joneschmidt/GradeCrossing/README.md

# GradeCrossing
Arduino code for a model railroad grade crossing controller

05/06/2024 updated with version 3.2 of the sketch
11/17/2022 updated with version 3.1 of the sketch
