joneschmidt/GradeCrossing/GradeCrossingBoardV1.1.pdf

### Grade Crossing Board V1.1

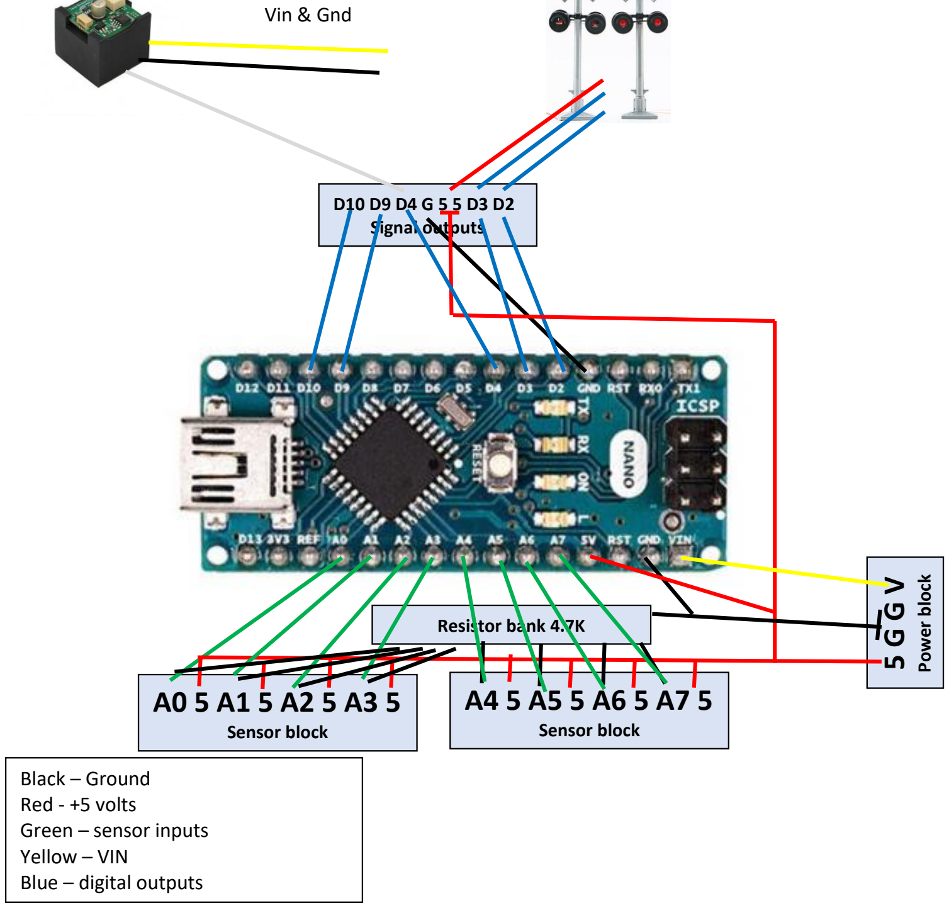
[picture p2: figure]
Sensor block; Vin & Gnd; D10 D9 D4 G 5 5 D3 D2 Signal outputs; Power block; Black – Ground Red - +5 volts Green – sensor inputs Yellow – VIN Blue – digital outputs; Resistor bank 4.7K

3/28/2022 10:35 AM

Iowa Scaled Engr
Soundbytes Crossing Bell

Walthers SceneMaster Crossing Flashers 510 Ω on common black lead to +5

### Grade Crossing Board V1.1

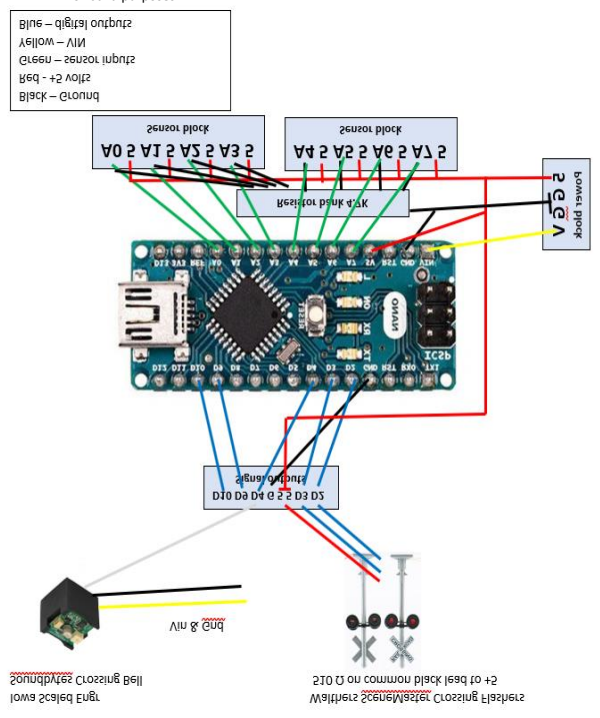
[picture p3: figure]

3/28/2022 10:35 AM

Underside – for build purposes
