joneschmidt/GradeCrossing/(commit log)

2022-07-10 Add files via upload
    Updated to GradeCrossing 3.0 This code is a major restructuring, with reworking the code for gate control servos.
2024-05-20 Clean, generic grade crossing sketch
    For 1 track crossing, but examples for move complex configuration.
